ryanjetplane1/RC-Foam-Plane/README.md

# RC-Foam-Plane
A fully custom low-speed RC glider hybrid with a 4ft wingspan edit
672807063-188e1a78-ac51-4c05-b2c2-54077f18bb9f

5d3572d3-89c9-477d-aa9a-0d288ec22889

## Overview

This project is a custom-designed RC airplane focused on customizability. The CAD model was fully unwrapped into flat schematics so the schematics can be printed and cut out easily. These parts are generic and can be controlled with any radio meant for RC.

**Features**

- 36-inch total span (250mm front, 400mm middle, 264mm back)
- 10mm flat wing angled at 3° with wings folded inwards at 5° for balancing
- Quick-release battery slot
- 2 ailerons and 1 back elevator servo

## How To Build

Start by printing out the schematics. Use them as a stencil to cut the pieces out of Adam Ready Board foam. The foam is 5mm thick so you must double layer it to 10mm for extra strength.

After cutting out the wings, insert 2 3mm-thick carbon fiber rods per wing for support. The rods are 3mm thick.

Mount your X2212 motor inset. Offset the motor slightly left to counter turning forces. Secure it with screws. Use hot glue for the rest of the foam frame.

Connect your servos to the ailerons and elevators using the push rod kit. Wire up your ZTW 30A ESC and BetaFPV ELRS receiver. Slide your 3S 2200mah LiPo into the slot between the wings. Attach the aluminum landing gear.

## Bill of Materials

| Component | Description | Qty | Price | Link |
| --- | --- | --- | --- | --- |
| ESC, Motor, Propeller, Push Rod, Servos | Airplane starter electronics kit | 1 | $33.95 | [Buy](https://www.amazon.com/dp/B0GRB114F1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) |
| BetaFPV ELRS Receiver | 2.4ghz receiver | 1 | $18.99 | [Buy](https://www.amazon.com/gp/product/B09WHLJ2GN/ref=ox_sc_act_title_1?smid=AHYBUG4B9GJPC&psc=1) |
| 3S 2200mAh LiPo | Battery with XT60 connector | 1 | $17.99 | [Buy](http://amazon.com/gp/product/B0GSVS3NVQ/ref=ewc_pr_img_1?smid=A1SO9P5VF1E6AC&psc=1) |
| 3mm Carbon Fiber Rod | For wing reinforcement | 1 | $9.99 | [Buy](http://amazon.com/gp/product/B0DGF1ZQYQ/ref=ox_sc_act_title_3?smid=A35BFBRDRD3RNK&psc=1) |
| Adam-Ready Board | 5mm foam board ($1.25 ea) | 5 | $6.25 | [Buy](https://www.dollartree.com/readi-board-white-foam-boards/809955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) |
| **Total** | | | **$87.17** | |

## Wiring Diagram
Basic Electronics setup guide for an rc plane\

## Why it failed
During prototyping, I had several issues with flight testing.
- The wings were accidentally assembled upside down because the flaps were cut incorrectly. This ruined the balance of the plane and caused it to curve right and crash repeatedly.
- The plane was tail-heavy at first. Finding the right center of gravity required two weeks of sanding down the wings.
- The vibrations from the motor ripped off the propeller during early tests.
- On the final flight, I lost all control in the ailerons due to the servo unplugging pre-flight. This caused the plane to dive straight into the ground.

## Failed Flight Testing
[https://youtu.be/UEISuyI58ok](https://youtu.be/rz_R7-Amrkw)
