ryanjetplane1/RC-Foam-Plane/parts.csv

Component | Description | Qty | Unit Price | Total Price | Link
ESC, Motor, Propeller, Push Rod, Servos | Airplane starter electronics kit | 1 | $33.95 | $33.95 | https://www.amazon.com/dp/B0GRB114F1?lv=shuf&redirect=true&channelId=500&plpRedirect=mhFallback
BetaFPV ELRS Receiver | 2.4ghz receiver | 1 | $18.99 | $18.99 | https://www.amazon.com/gp/product/B09WHLJ2GN/ref=ox_sc_act_title_1?smid=AHYBUG4B9GJPC&psc=1
3S 2200mAh LiPo | Battery with XT60 connector | 1 | $17.99 | $17.99 | http://amazon.com/gp/product/B0GSVS3NVQ/ref=ewc_pr_img_1?smid=A1SO9P5VF1E6AC&psc=1
3mm Carbon Fiber Rod | For wing reinforcement | 1 | $9.99 | $9.99 | http://amazon.com/gp/product/B0DGF1ZQYQ/ref=ox_sc_act_title_3?smid=A35BFBRDRD3RNK&psc=1
Adam-Ready Board | 5mm foam board | 5 | $1.25 | $6.25 | https://www.dollartree.com/readi-board-white-foam-boards/809955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
Total Cost |  |  |  | $87.17
