ryanjetplane1/RC-Foam-Plane/CAD/Foam Plane.step

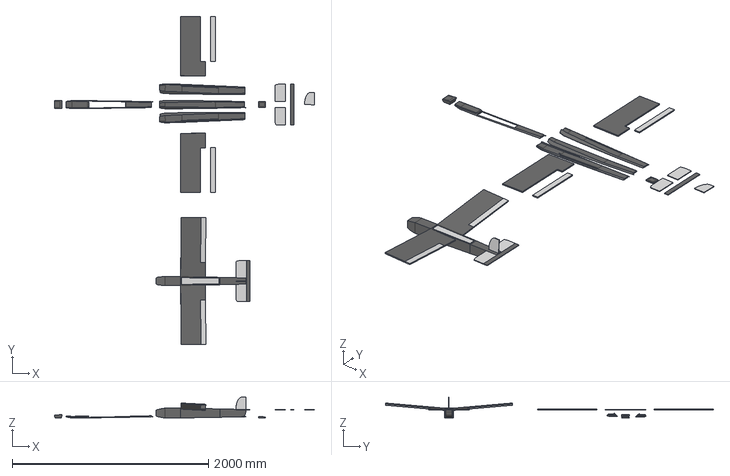
[picture p1: CAD file, 2026-09-22]
CAD/Foam Plane.step
2656.9 x 3346.5 x 214.2 mm
