ryanjetplane1/RC-Foam-Plane/(list of files, cad)

Other CAD files:
CAD/Foam Plane.f3d
CAD/Foam Plane.stl
