ryanjetplane1/RC-Foam-Plane/(commit log)

2026-09-20 Update description in stl.txt
    Clarify the purpose of the model and the availability of data.
2026-09-20 Add bill of materials (BOM) for airplane project
2026-10-13 Update parts.csv format and remove BOM header
    Removed BOM header and updated the CSV format.
